9-Fakrizz/SwarmRobot/report pipeline inspector.pdf

## Flying Pipe Inspection Robot Report Jan 2024 – April 2024

## 1. Overall Design

2. Body and Chassis Design. 3.List of Components.
4.Testing Components.
5. Block Diagram.
6. Circuit Diagram.

## 7. Estimate Thrust

8. Programming.

## 9.Final Conclusion

## Overall Handsketch Design

This design prioritizes simplicity for ease of construction and adherence to deadlines. The robot consists of two main parts: a chassis and a drone body.

- Chassis: The chassis is the base of the robot and houses the two wheels. It should be sturdy enough to support the weight of the robot and be designed to allow for easy attachment of the drone body.
- Drone Body: The drone body sits on top of the chassis and houses the brushless motors and propellers that will enable the robot to fly. It will also house other components such as the battery, sensors, and any electronics necessary for control.

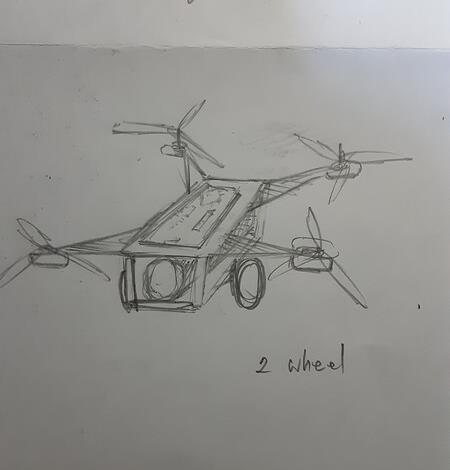
[picture p1: figure]

## Body and Chassis Design

Your design uses a Betaflight Meteor85 drone kit for the main flight body. The chassis should be designed to connect securely to the Betaflight Meteor85 body. Here are the key considerations:

- Dimensions: Measure the Betaflight Meteor85 body to ensure your chassis design fits it exactly.
- Connection Points: Design the chassis to have mounting points that match the Betaflight Meteor85 body for a secure connection.
- Material: Choose lightweight, strong material like ABS or PLA filament for the chassis.

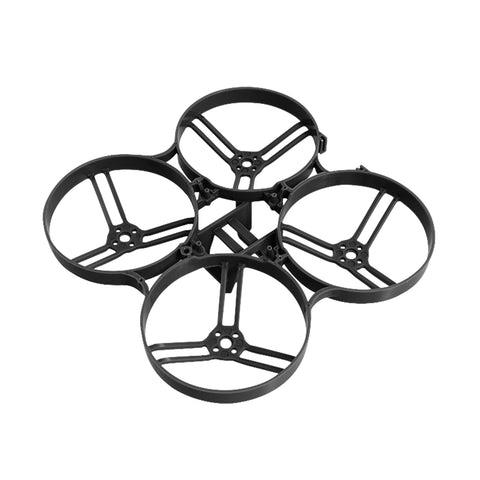
[picture p2: figure]
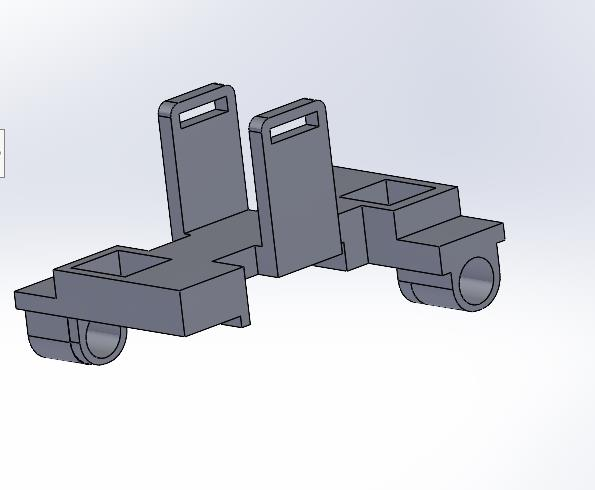
[picture p3: figure]

List of components.

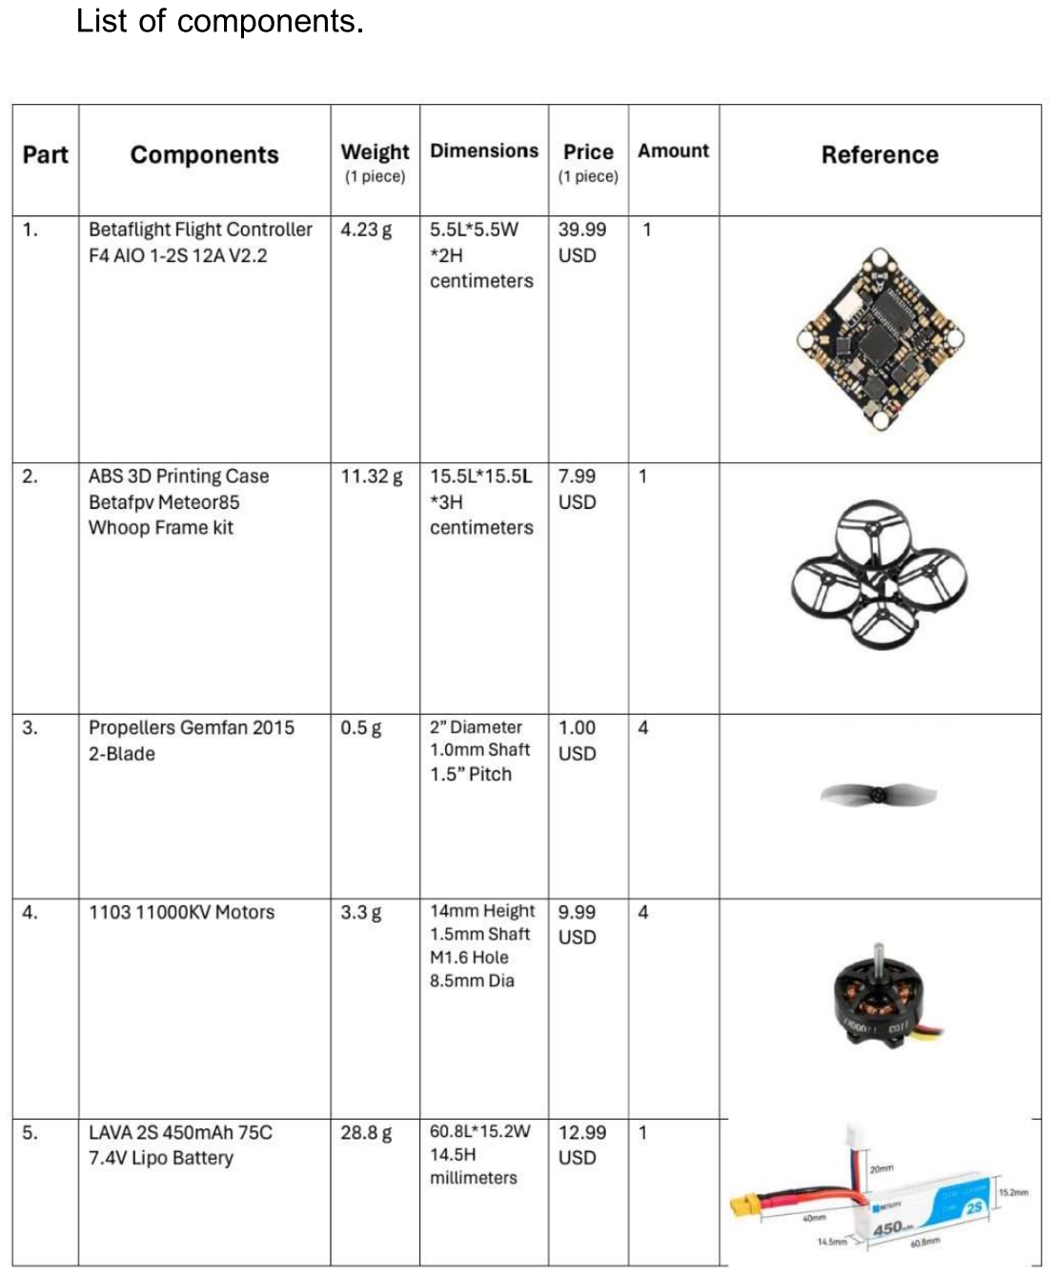
[picture p4: page 4]
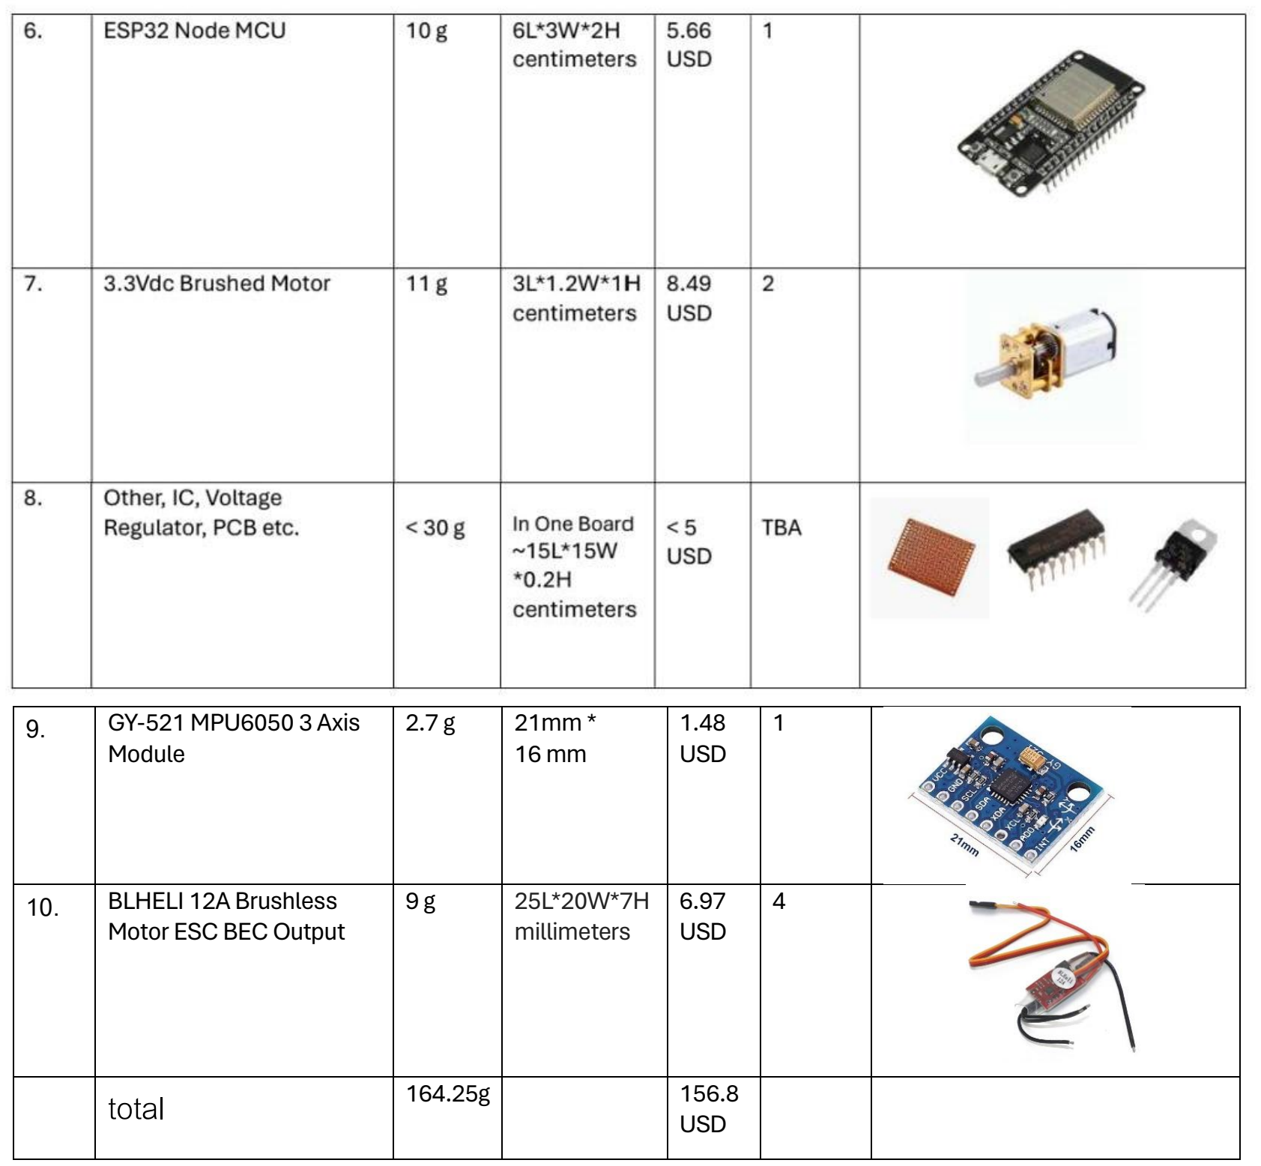
[picture p5: page 5]

9. GY-521 MPU6050 3 Axis | Module | 2.7 g | 21mm * 16 mm | 1.48 USD | 1
10. BLHELI 12A Brushless | Motor ESC BEC Output | 9 g | 25L*20W*7H millimeters | 6.97 USD | 4
| total | 164.25g | | 156.8 USD

## Testing Components

This report details the testing and integration procedures conducted for a mobile robot with both wheeled and flight system functionalities. The testing focused on evaluating individual components and resolving encountered challenges to achieve a stable and controllable robot.

### 1. Introduction

The experiment aimed to develop a mobile robot capable of ground and aerial movement. This report details the testing processes for the key components in each system:

- Wheel System: DC motor, chassis structure, and wheel structure.
- Flight System: Brushless motors with ESCs (Electronic Speed Controllers), gyro sensor, communication protocol, and control method.

### 2. Wheel System Testing

### 2.1 Observations

Initial testing revealed instability in the front wheel, causing the robot to veer off course and travel in a curved path.

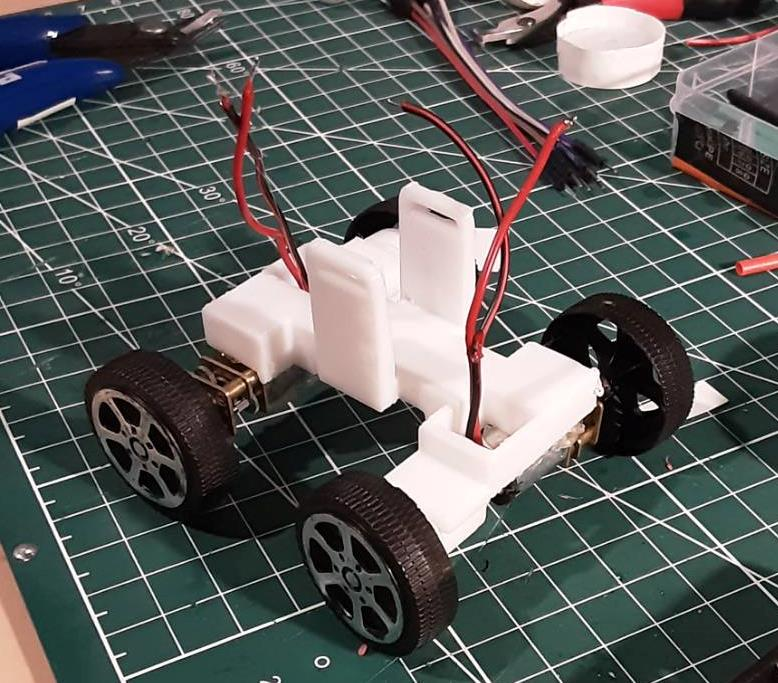
[picture p6: figure]
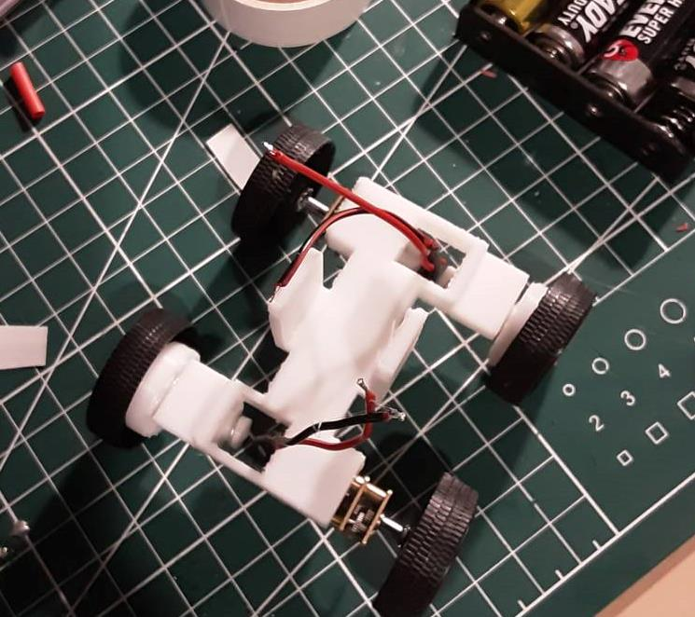
[picture p7: figure]

### 2.2 Solution

The front wheel was secured using glue to enhance its stability. This intervention resulted in straighter travel for the wheeled system.

### 3. Flight System Testing

### 3.1 Communication Protocol

The initial approach involved using an ESP32 microcontroller to communicate with the flight controller board via the SBUS protocol. However, after numerous attempts, configuring the flight controller board for successful SBUS reception proved challenging and time-consuming.

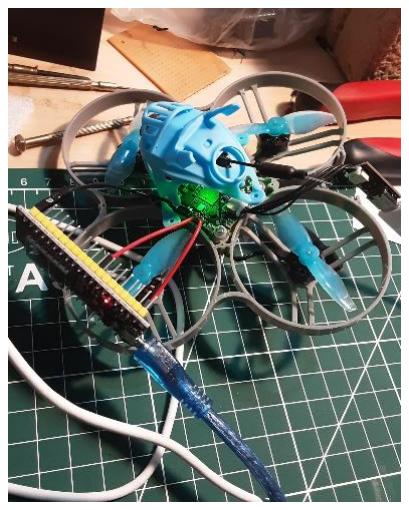
[picture p8: figure]

### 3.2 Control Method

Given the difficulties with SBUS communication, an alternative control method was adopted. This involved sending PWM signals directly to the ESCs for controlling the BLDC motors.

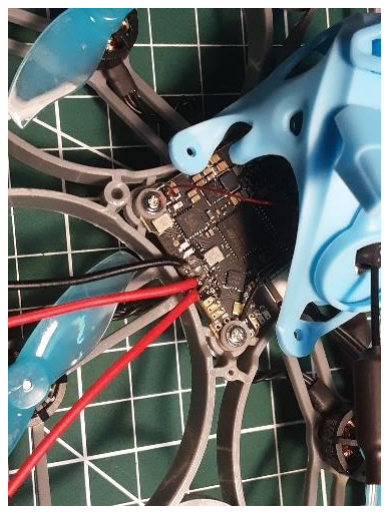
[picture p9: figure]

### 3.3 BLDC Motor Control

Initially, the BLDC motors encountered stuttering issues. This problem was resolved through adjustments and tuning of the ESC settings.

### 3.4 Flight System Stabilization

A GY-521 MPU6050 sensor was integrated for the PID (Proportional-Integral-Derivative) control method to further enhance the stability of the flight system. This sensor functioned without any errors during testing.

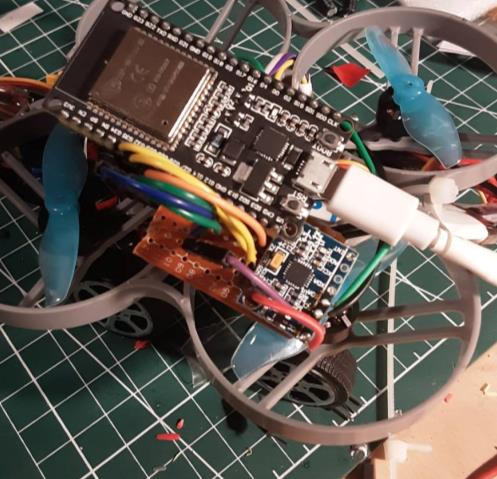
[picture p10: figure]

### 4. Results

While all components functioned individually, the challenges encountered with the initial SBUS communication method highlighted the need for alternative approaches for flight system control.

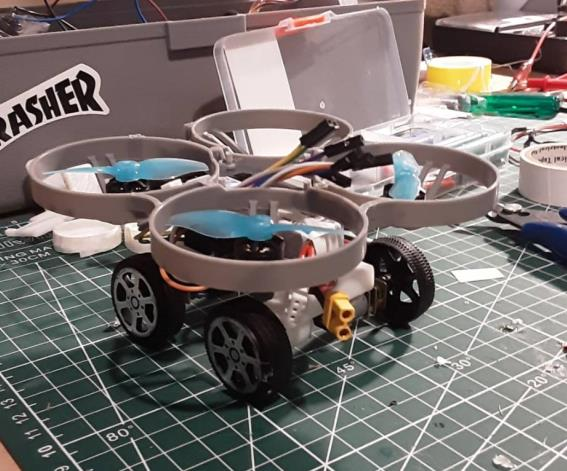
[picture p11: figure]

### 5. Conclusion

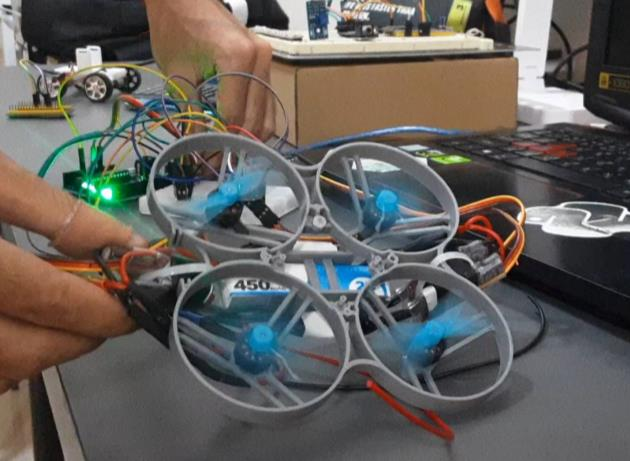
[picture p12: figure]

Component testing identified flight system improvements needed. Securing the front wheel stabilized the wheeled system. We'll explore alternative communication methods for a more efficient and reliable flight control system. Future work includes implementing a viable communication protocol and refining the PID control system for optimal flight stability. optimal flight stability.

## Block Diagram

The picture shows the electronic parts of a robot. The transmitter (Blynk IoT) sends signals to the receiver, which tells the motor controller how fast to spin the motor. The motor controller also powers a steering motor.

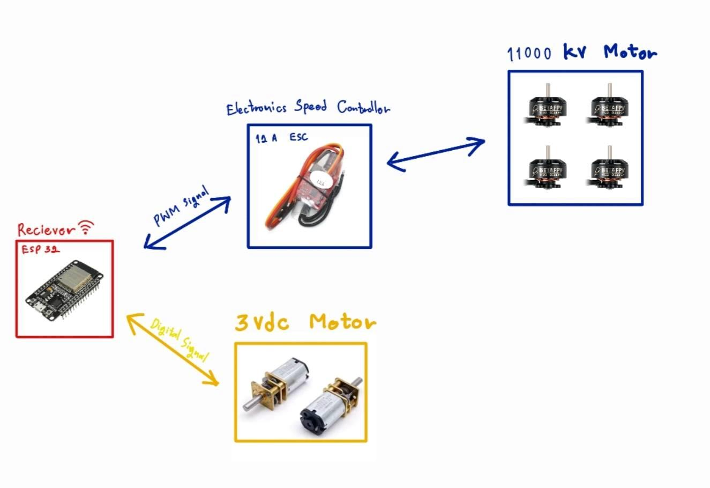
[picture p13: figure]

## Circuit Design

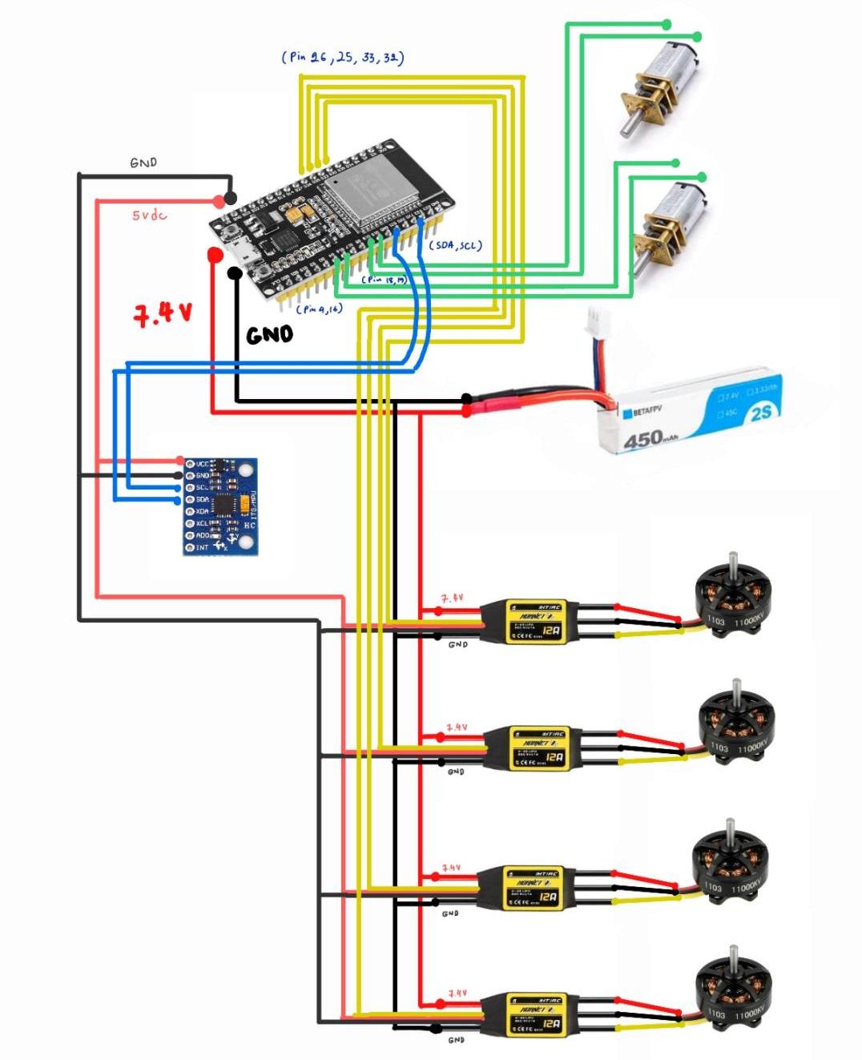
[picture p14: figure]

## Estimate Thrust Generated by Brushless Motors

This section estimates the lift force (thrust) generated by the four brushless motors in your robot.

Motor Specifications:

- Motor KV rating: 11000 KV
- Operating voltage: 7.0 V (adjusted for safety from 7.4V)
- Estimated efficiency: 60%

Calculation

The motor's rotational speed (RPM) is estimated using the formula:

- RPM = Kv * Voltage * Efficiency
- RPM = 11000 KV * 7.0 V * 0.6 ≈ 46200 RPM

T-Motor F1103 Motor 8000kv 11000kv 2s 3s (quadcopters.co.uk) (https://www.quadcopters.co.uk/t-motor-f1103-motor-8000kv-11000kv-2s-3s)

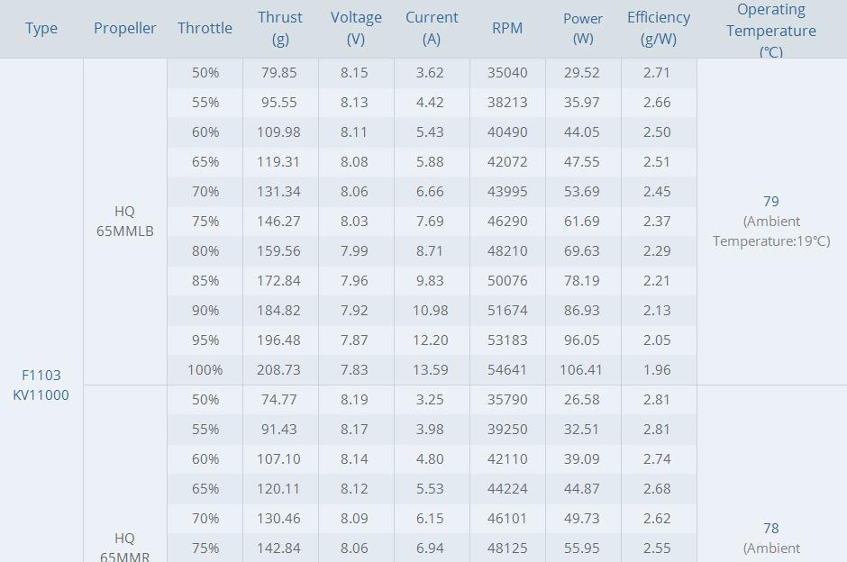
[picture p15: figure]

Calculation

The lift force using the formula:

- Force = Thrust * Number of motors
- Force = 130.46 * 4 = 521.84 g

Conclusion

Based on an estimation of the lift force generated by four brushless motors, The robot can be lifted with 100% throttle. Because of the weight of the robot does not exceed to 521.84 grams.

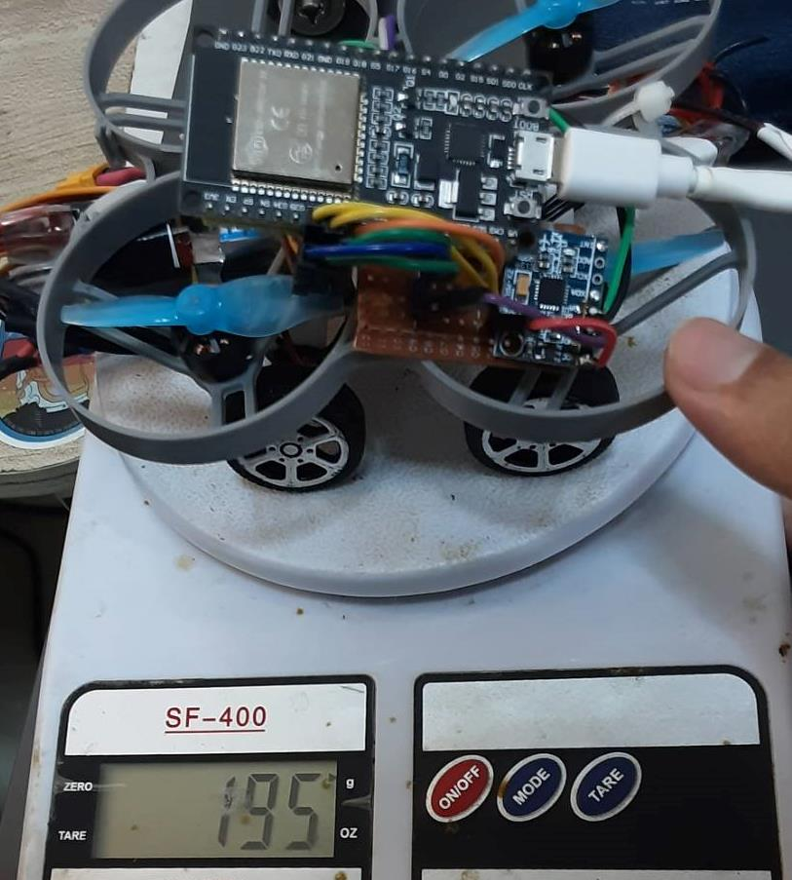
[picture p16: figure]

## Programming

Testing confirmed functionality of all components:
Wheel System: DC motors, chassis structure, and wheel structure. Flight System: Brushless motors, ESCs, and GY-521 MPU6050 sensor.

### 1. Control Software Development

Two software classes were created:
1.1 Motor Control: Provides functions for forward, backward, left, and right rotations.
1.2 Flight Control: Utilizes the MPU6050 sensor data for PID control of the four brushless motors.

### 4. Flight Control Optimization

Initial testing of the flight control system highlighted the need for sensor calibration and PID parameter tuning. The MPU6050 sensor requires constant calibration to maintain accurate readings. Additionally, the PID controller's proportional, integral, and derivative gains need further adjustment for optimal flight stability.

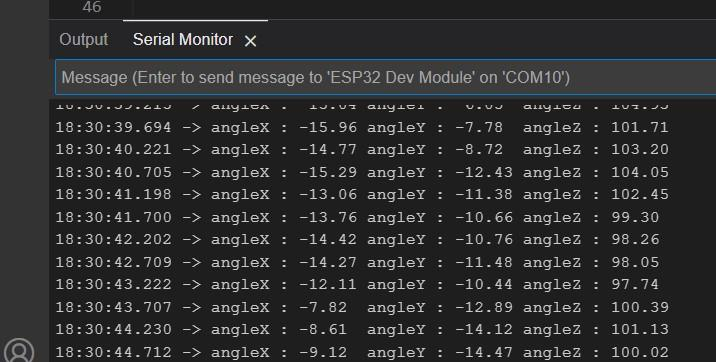
[picture p17: figure]

### 5. Conclusion

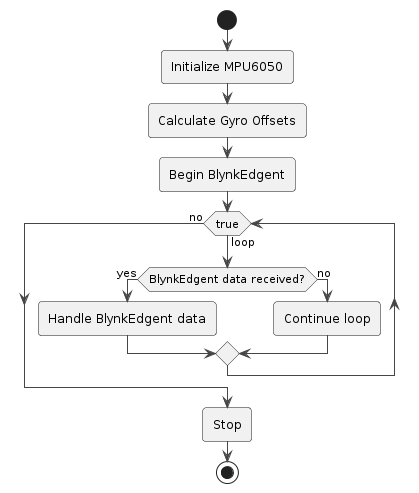
[picture p18: figure]

The experiment successfully developed control software for both wheeled and flight systems. However, the flight control system necessitates ongoing calibration and PID tuning to achieve desired stability.

## Final Conclusion

The mobile robot development achieved functionality in both wheeled and flight systems, demonstrating the potential for a versatile mobile platform. However, several key areas require further development:
Wheel System: While operational, the robot's movement speed is limited by the low 3.3V power supply. Upgrading to a higher voltage battery will significantly improve performance. Flight System: Software development successfully established basic control functionalities using the MPU6050 sensor and PID control. However, hardware limitations emerged as two ESCs were found to be malfunctioning, restricting operation to only two BLDC motors.

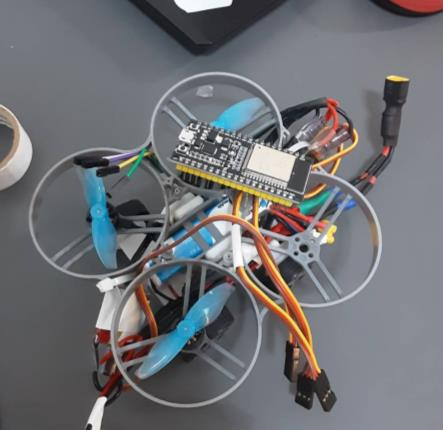
[picture p19: figure]
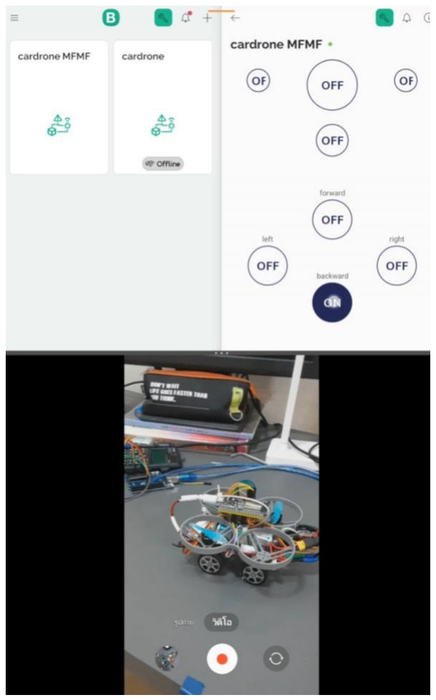
[picture p20: figure]
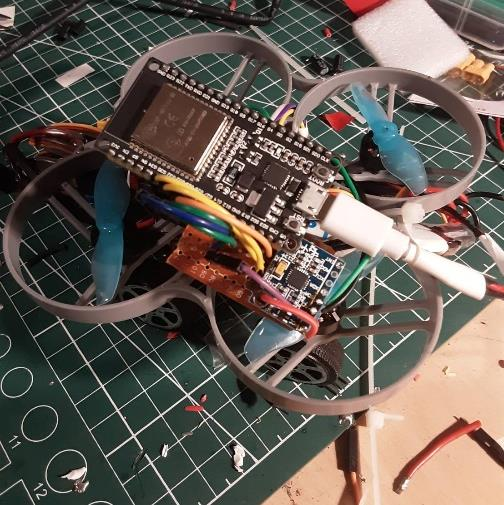
[picture p21: figure]

Despite these limitations, the robot's ability to rotate with high acceleration using just two functional BLDC motors highlights its potential for aerial maneuvers. Additionally, successful integration with Blynk IoT for Wi-Fi control demonstrates a foundation for remote control capabilities.

Moving Forward:
Replacing the faulty ESCs will enable full utilization of all four BLDC motors, potentially achieving sufficient thrust for liftoff.
Continued software development will focus on sensor calibration, PID tuning, and potentially incorporating additional sensors for enhanced flight control.
Upgrading the power source will address the limited speed of the wheeled system.

By addressing these areas, the mobile robot development can progress towards achieving its full potential for combined ground and aerial movement.
